dnk1000/Tandon-Tester-V2/docs/reference/kicad/PRELIMINARY_BOM.csv

Ref | Qty | Value/Part | Function | Status
U1 | 1 | ESP32-S3-WROOM-1-N8 | MCU | baseline
U2-U3 | 2 | SN74LS06 | open-collector floppy outputs | baseline
U4 | 1 | SN74LVC14A | 5V-tolerant Schmitt input buffer | baseline
U5 | 1 | LMR51430 | 12V to 5V 3A buck | baseline
U6-U7 | 2 | INA226 | current/voltage monitors | baseline
U8 | 1 | TLV75533 or equivalent | 3.3V regulator | select exact part
J1 | 1 | 2x17 shrouded 0.1in IDC | 34-pin floppy interface | select footprint
J2 | 1 | 4-pin TM100 power mating connector | drive power | select exact connector
J3 | 1 | USB-C USB2 device receptacle | console/programming | select exact connector
J4 | 1 | 12VDC input connector | power input | select exact connector
SW3 | 1 | DPDT locking toggle | physical Write Enable | select exact part
R30-R33 | 4 | 150R 0.5W | removable input termination | baseline
R40-R43 | 4 | 100R | input series damping/protection | baseline
R50-R51 | 2 | 0.025R 1% >=0.5W | current shunts | baseline
R60 | 1 | 100k 1% | buck top feedback | TI example
R61 | 1 | 13.7k 1% | buck bottom feedback | TI example
L1 | 1 | 6.8uH >=4A RMS >=5A sat | buck inductor | TI example
C11-C12 | 2 | 4.7uF 50V X7R | buck input ceramics | TI recommendation
C13-C14 | 2 | 22uF 25V X7R | buck output ceramics | TI example
C10 | 1 | 0.1uF | buck bootstrap | TI example
F1 | 1 | 3.15A | input fuse | verify
D1 | 1 | SMBJ15A or suitable | 12V input TVS | verify exact part
