dnk1000/Tandon-Tester-V2/docs/reference/kicad/TM100_Tester.sch

## KiCad design docs/reference/kicad/TM100_Tester.sch (2026-10-17)

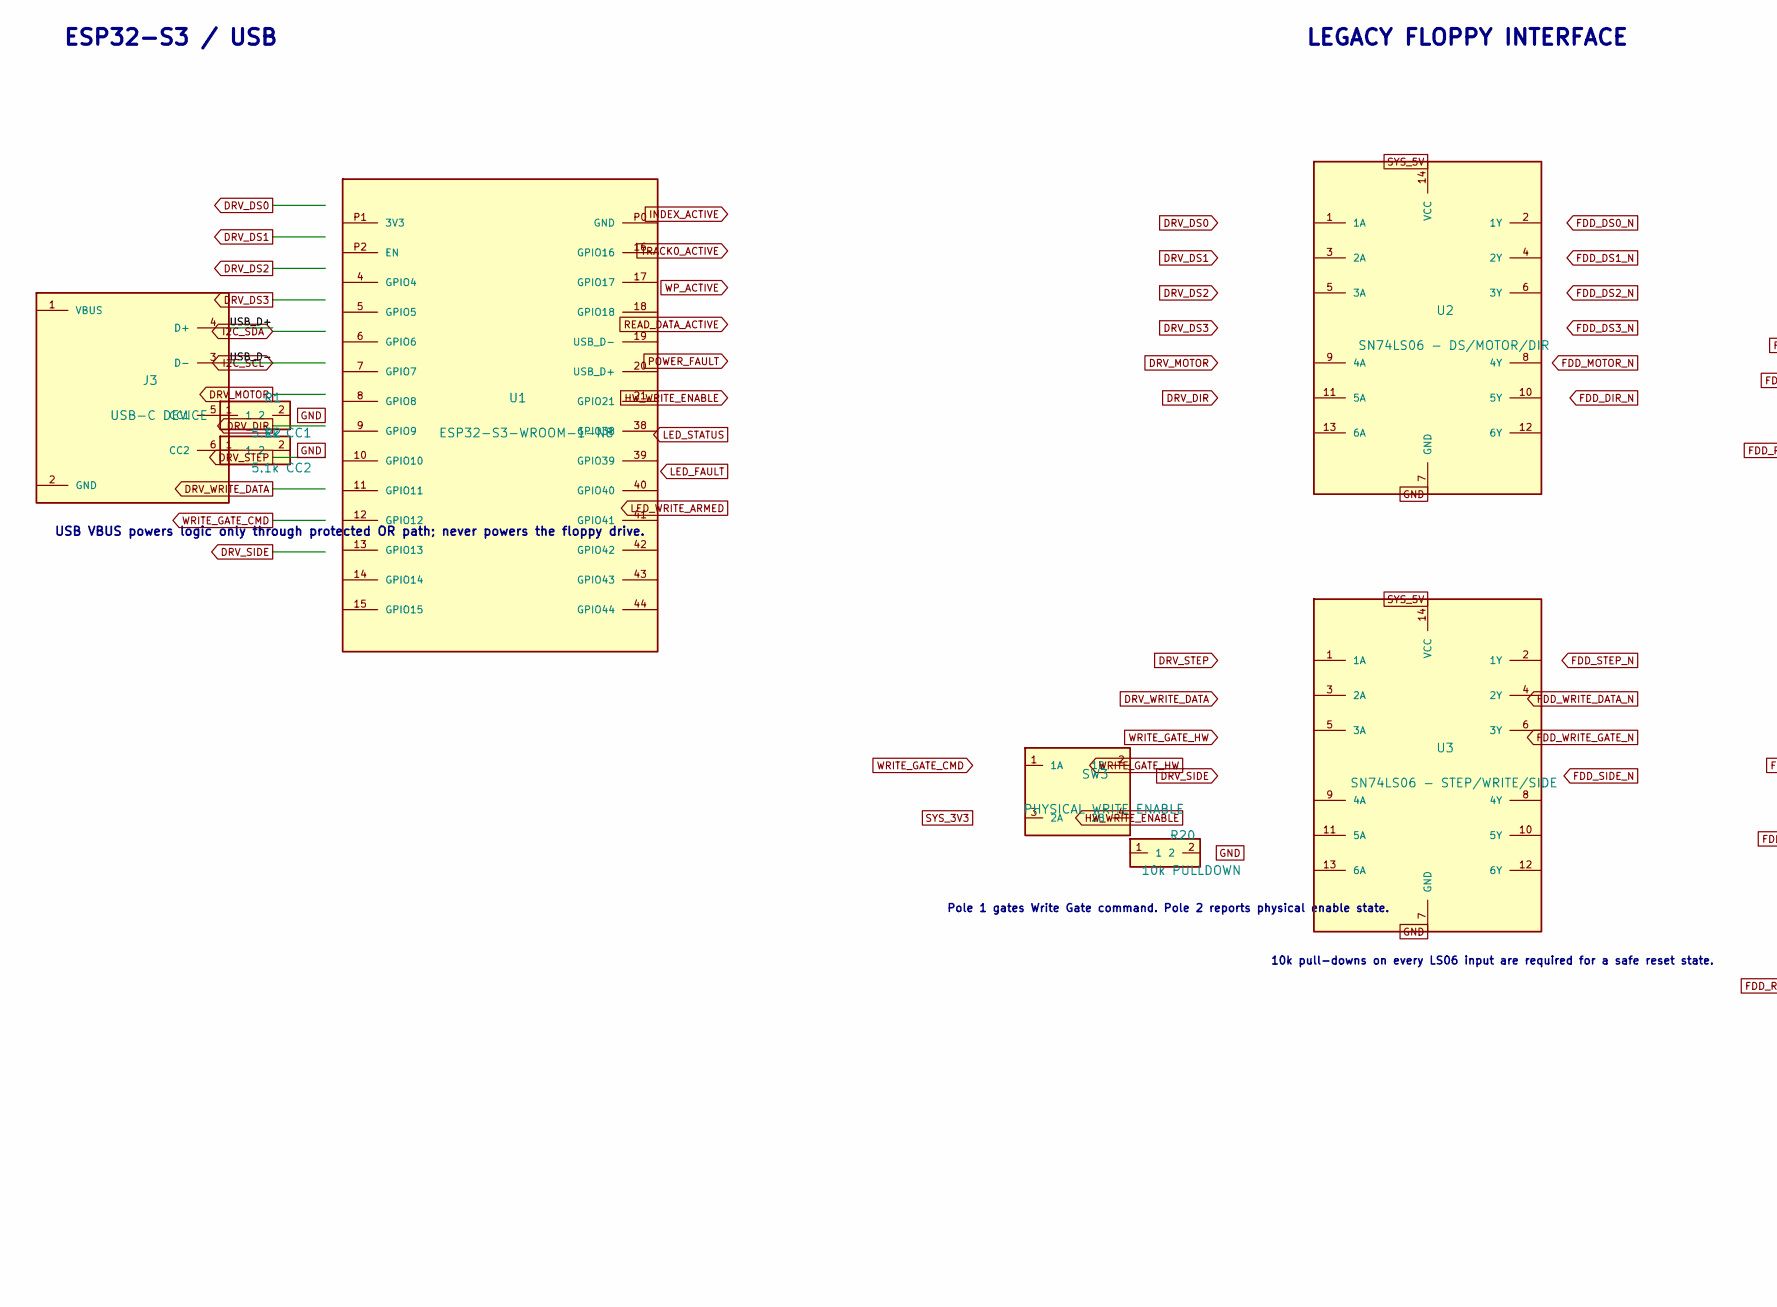
[picture p1: schematic TM100_Tester.sch, part in row 1, column 1]

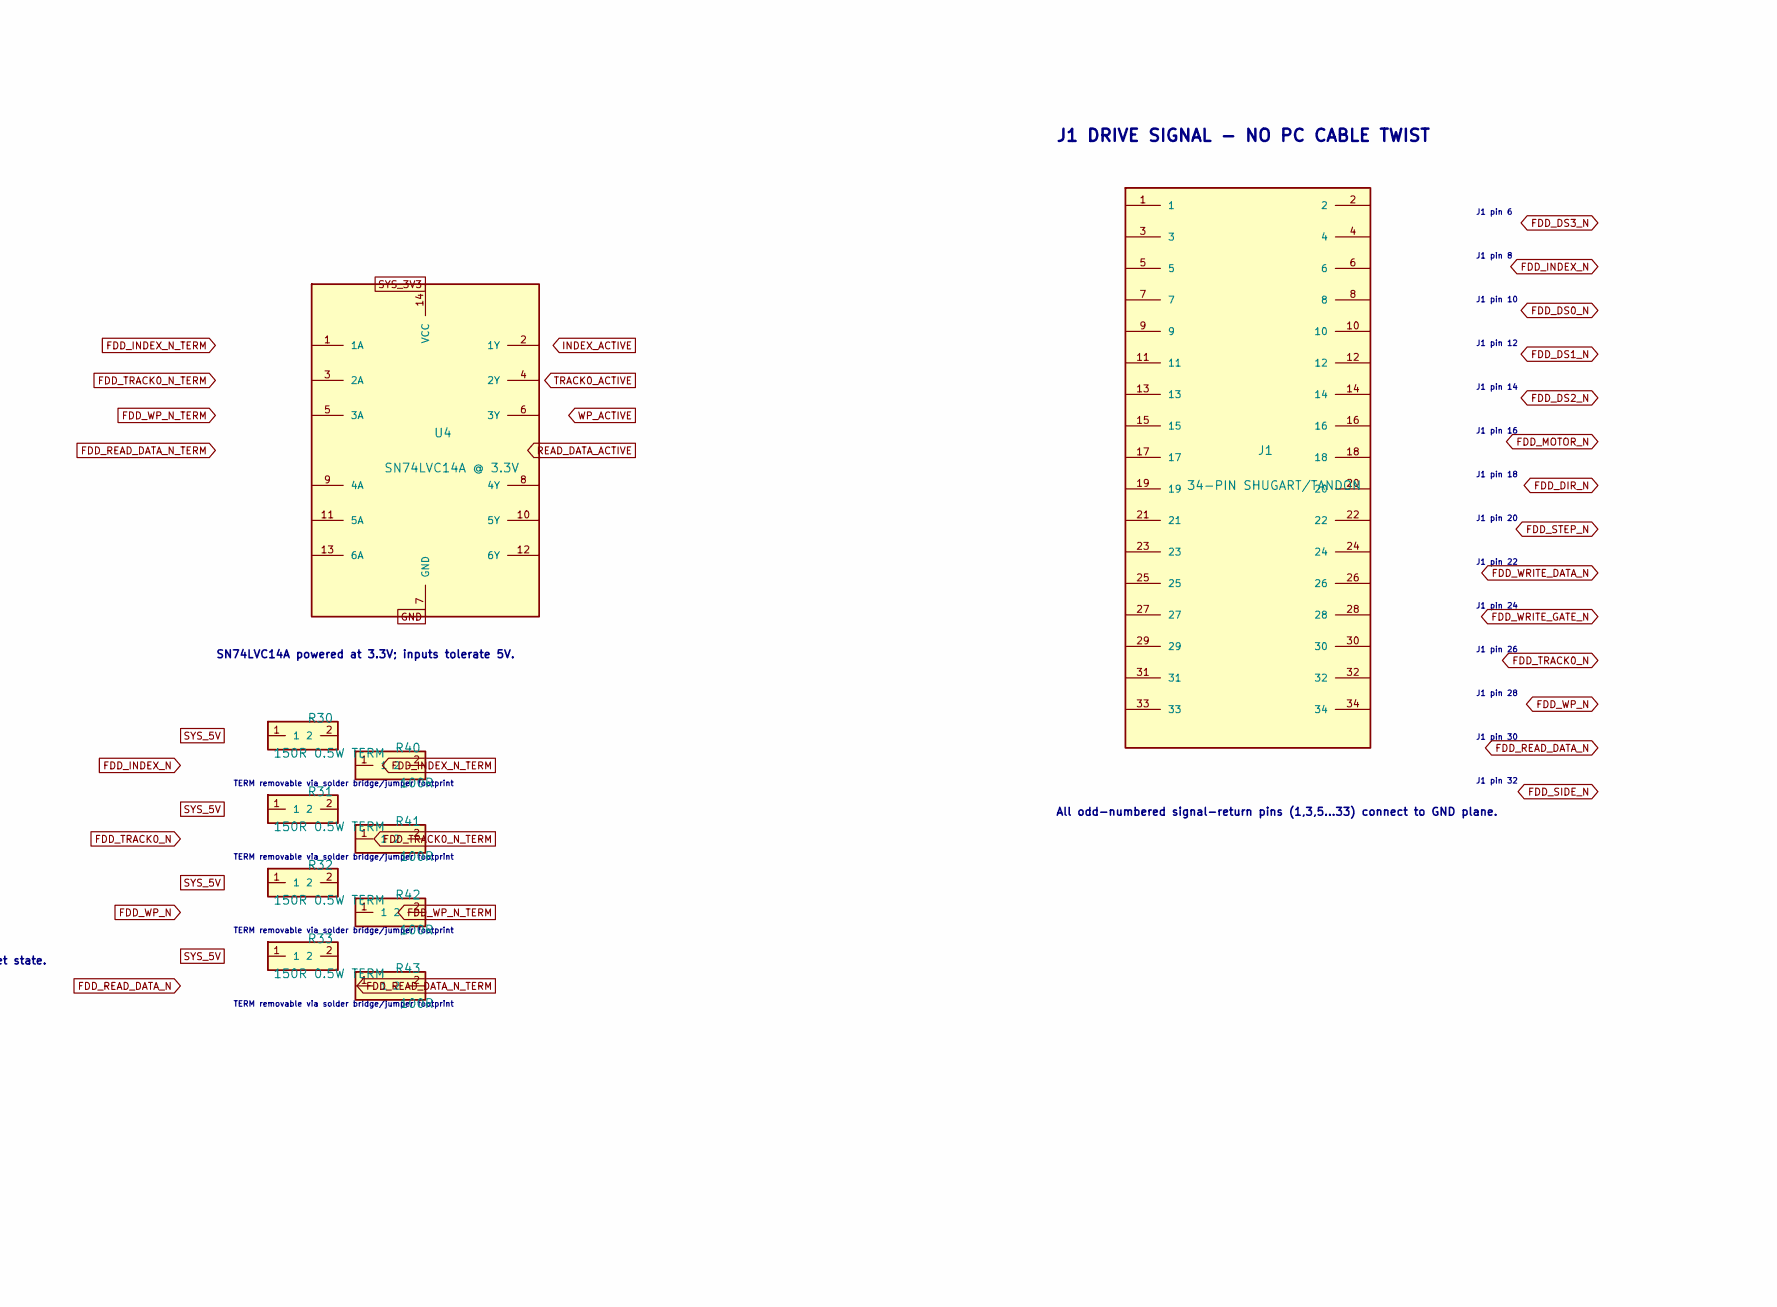
[picture p2: schematic TM100_Tester.sch, part in row 1, column 2]

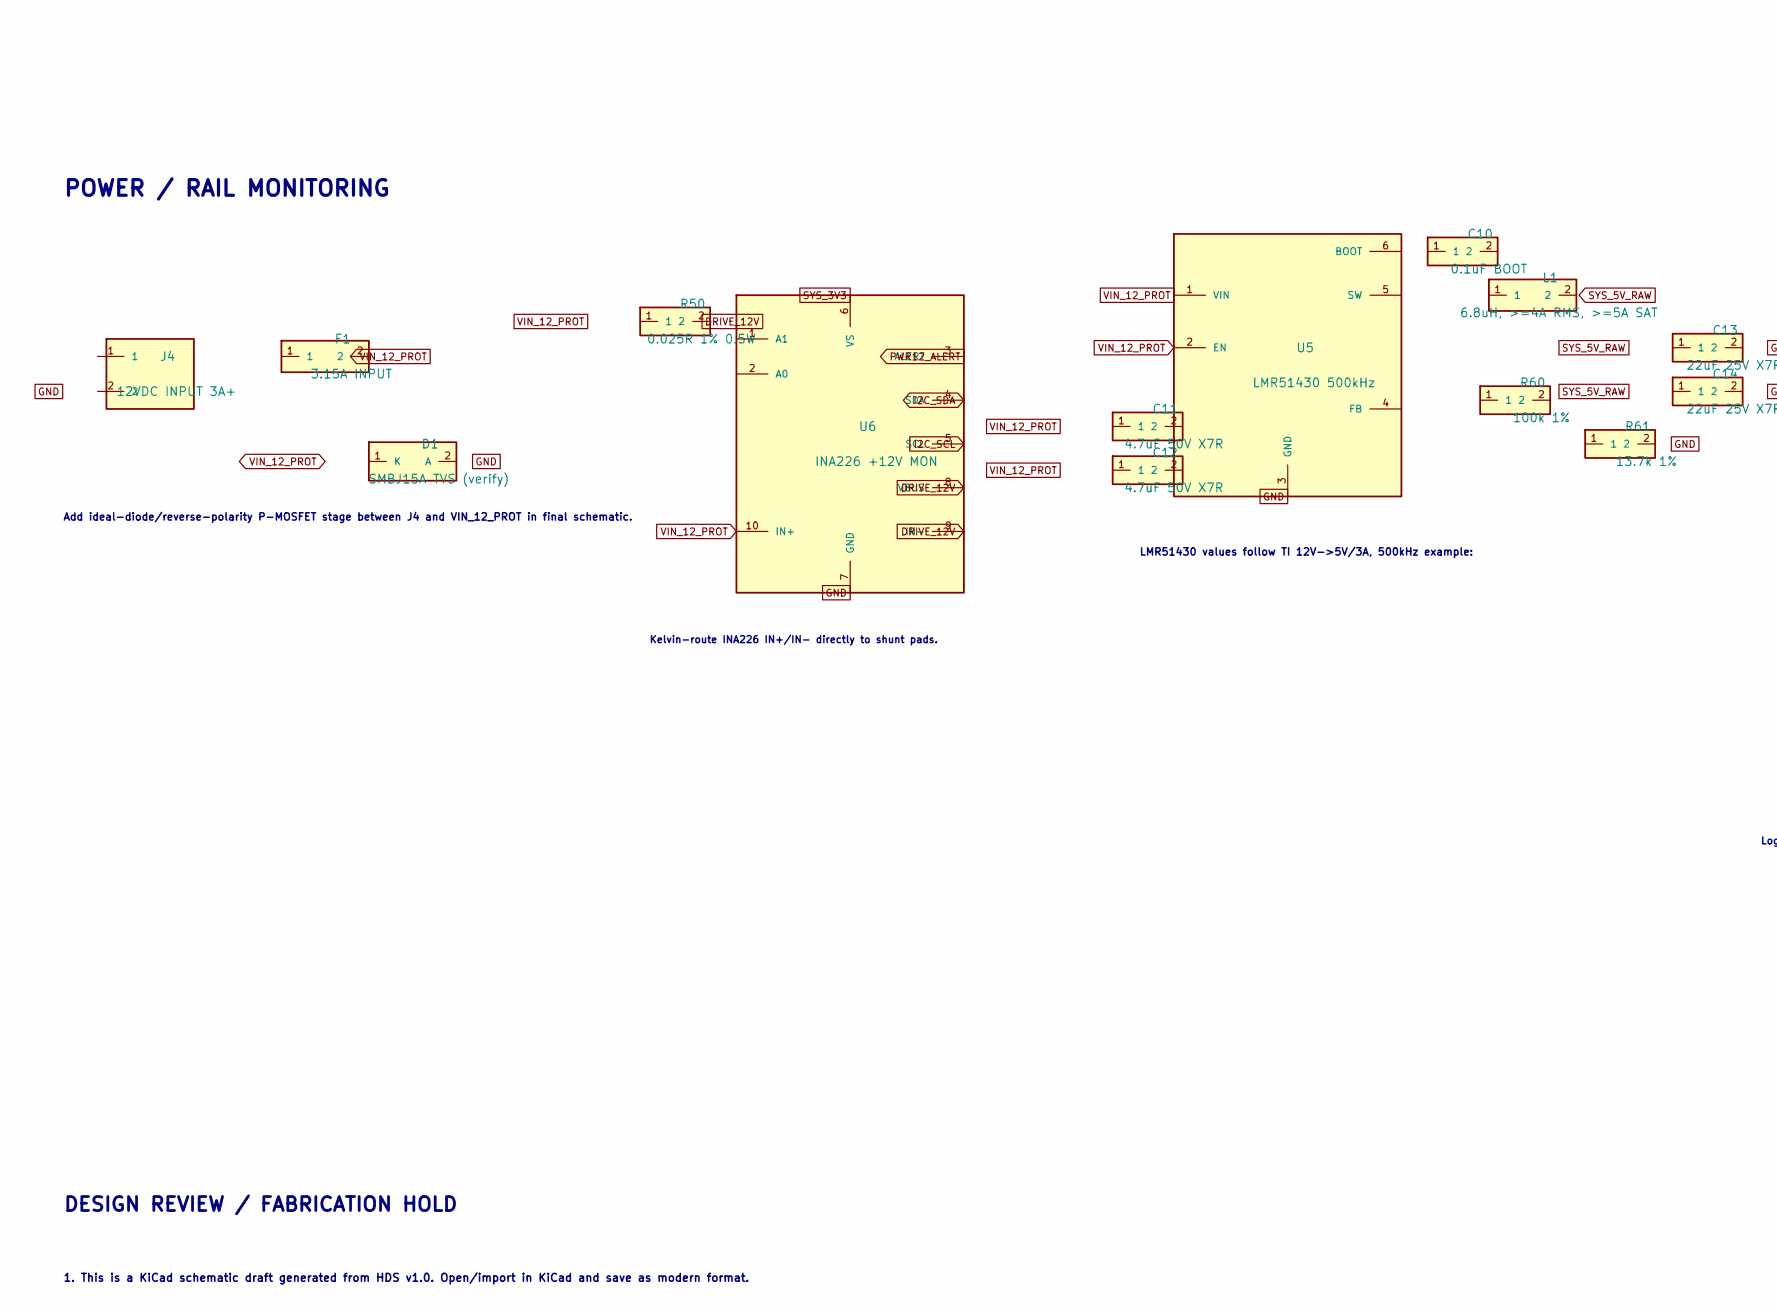
[picture p3: schematic TM100_Tester.sch, part in row 2, column 1]

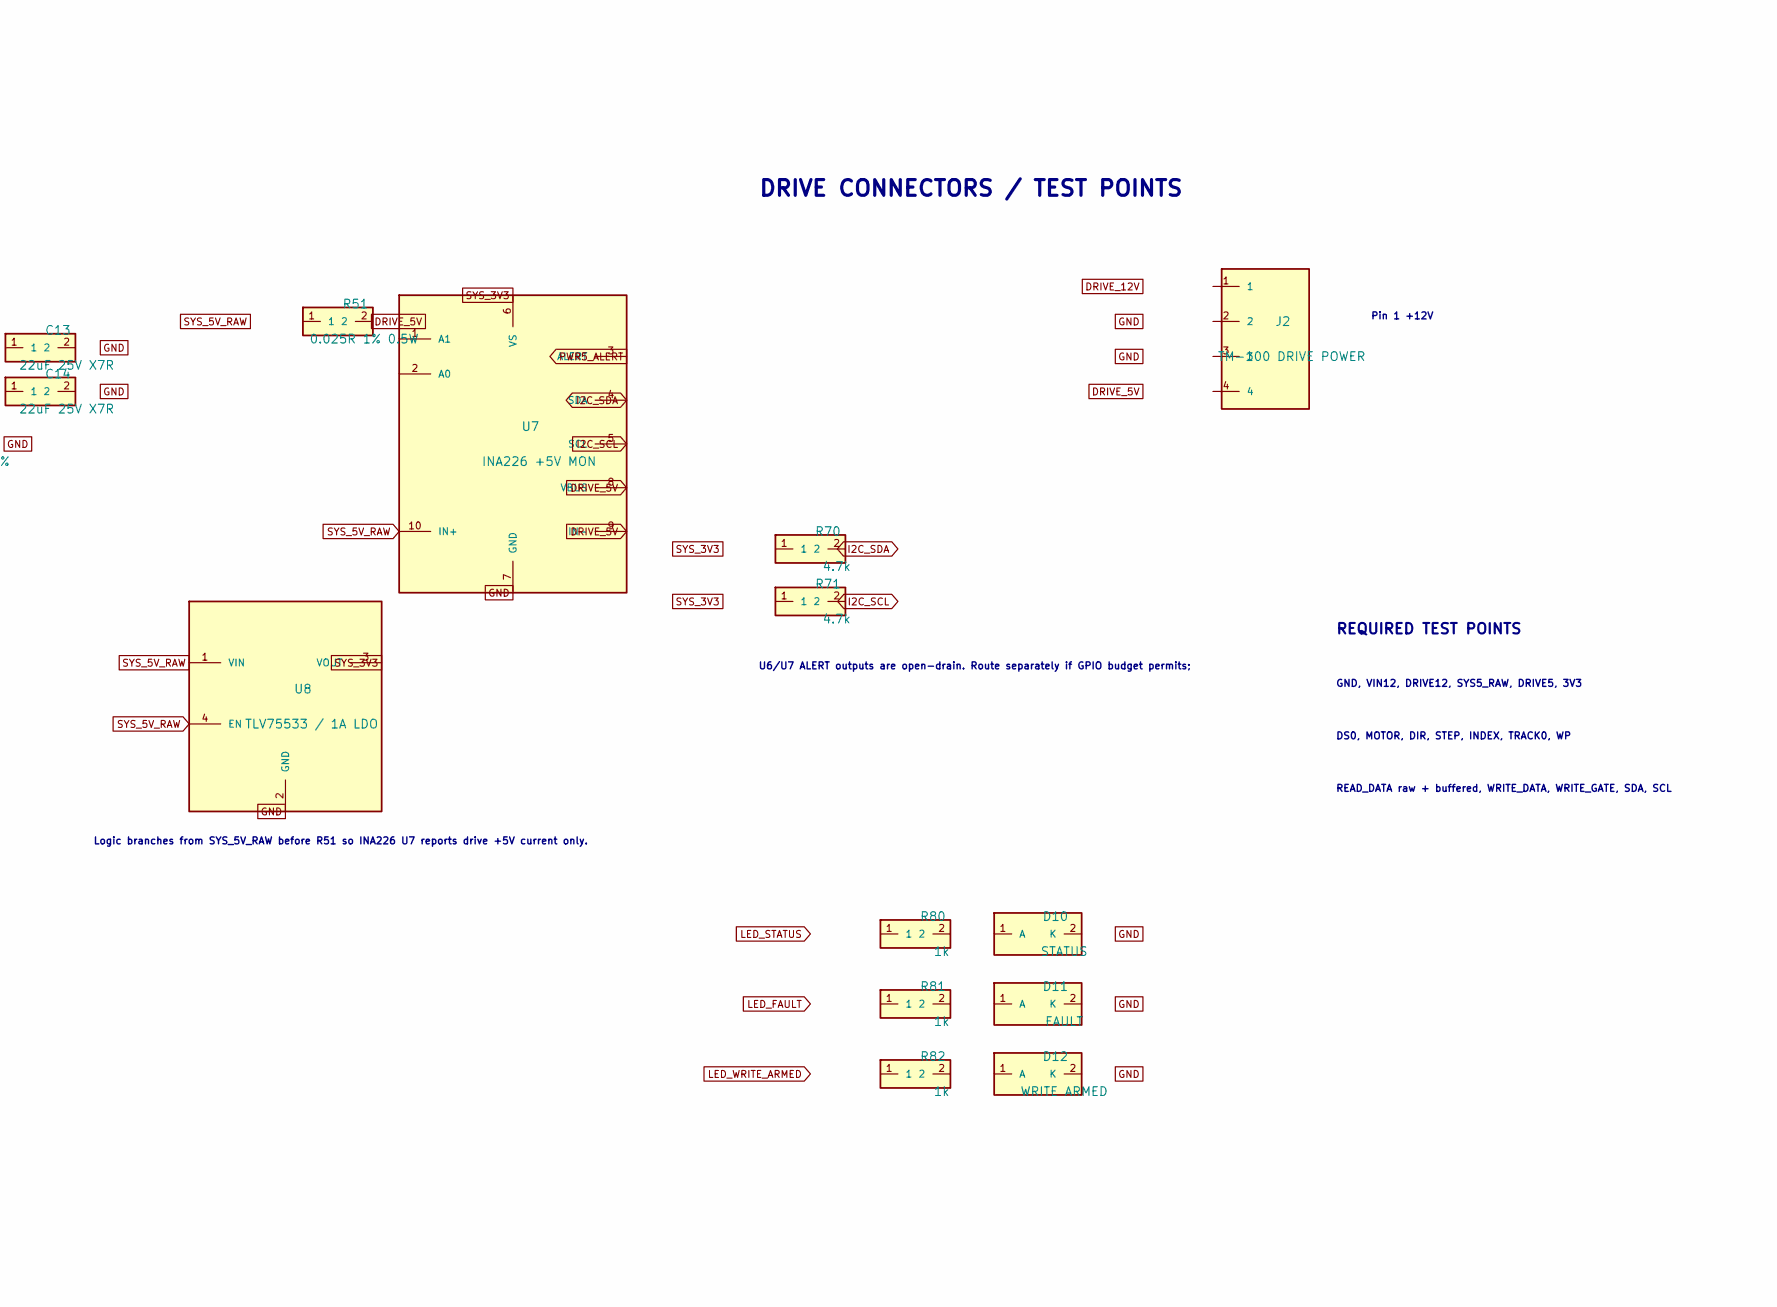
[picture p4: schematic TM100_Tester.sch, part in row 2, column 2]

Parts:
C10: 0.1uF BOOT
C11, C12: 4.7uF 50V X7R
C13, C14: 22uF 25V X7R
D1: SMBJ15A TVS (verify)
D10: STATUS
D11: FAULT
D12: WRITE ARMED
F1: 3.15A INPUT
J1: 34-PIN SHUGART/TANDON
J2: TM-100 DRIVE POWER
J3: USB-C DEVICE
J4: 12VDC INPUT 3A+
L1: 6.8uH, >=4A RMS, >=5A SAT
R1: 5.1k CC1
R2: 5.1k CC2
R20: 10k PULLDOWN
R30, R31, R32, R33: 150R 0.5W TERM
R40, R41, R42, R43: 100R
R50, R51: 0.025R 1% 0.5W
R60: 100k 1%
R61: 13.7k 1%
R70, R71: 4.7k
R80, R81, R82: 1k
SW3: PHYSICAL WRITE ENABLE
U1: ESP32-S3-WROOM-1-N8
U2: SN74LS06 - DS/MOTOR/DIR
U3: SN74LS06 - STEP/WRITE/SIDE
U4: SN74LVC14A @ 3.3V
U5: LMR51430 500kHz
U6: INA226 +12V MON
U7: INA226 +5V MON
U8: TLV75533 / 1A LDO

Connections:
DRIVE_5V: U7.8 (VBUS), U7.9 (IN-)
DRIVE_12V: U6.8 (VBUS), U6.9 (IN-)
GND: U2.7 (GND), U3.7 (GND), U4.7 (GND), U5.3 (GND), U6.7 (GND), U7.7 (GND), U8.2 (GND)
I2C_SCL: J3.3 (D-), U6.5 (SCL), U7.5 (SCL)
I2C_SDA: U6.4 (SDA), U7.4 (SDA)
PWR5_ALERT: U7.3 (ALERT)
PWR12_ALERT: U6.3 (ALERT)
SYS_3V3: U4.14 (VCC), U6.6 (VS), U7.6 (VS), U8.3 (VOUT)
SYS_5V: U2.14 (VCC), U3.14 (VCC)
SYS_5V_RAW: U7.10 (IN+), U8.1 (VIN), U8.4 (EN)
USB_D+: J3.4 (D+)
VIN_12_PROT: U5.1 (VIN), U5.2 (EN), U6.10 (IN+)

Notes on the sheet:
ESP32-S3 / USB
LEGACY FLOPPY INTERFACE
POWER / RAIL MONITORING
DRIVE CONNECTORS / TEST POINTS
USB VBUS powers logic only through protected OR path; never powers the floppy drive.
10k pull-downs on every LS06 input are required for a safe reset state.
Pole 1 gates Write Gate command. Pole 2 reports physical enable state.
SN74LVC14A powered at 3.3V; inputs tolerate 5V.
TERM removable via solder bridge/jumper footprint
J1 DRIVE SIGNAL - NO PC CABLE TWIST
J1 pin 6
J1 pin 8
J1 pin 10
J1 pin 12
J1 pin 14
J1 pin 16
J1 pin 18
J1 pin 20
J1 pin 22
J1 pin 24
J1 pin 26
J1 pin 28
J1 pin 30
J1 pin 32
All odd-numbered signal-return pins (1,3,5...33) connect to GND plane.
Pin 1 +12V
Add ideal-diode/reverse-polarity P-MOSFET stage between J4 and VIN_12_PROT in final schematic.
Kelvin-route INA226 IN+/IN- directly to shunt pads.
LMR51430 values follow TI 12V->5V/3A, 500kHz example:
Logic branches from SYS_5V_RAW before R51 so INA226 U7 reports drive +5V current only.
U6/U7 ALERT outputs are open-drain. Route separately if GPIO budget permits;
REQUIRED TEST POINTS
GND, VIN12, DRIVE12, SYS5_RAW, DRIVE5, 3V3
DS0, MOTOR, DIR, STEP, INDEX, TRACK0, WP
READ_DATA raw + buffered, WRITE_DATA, WRITE_GATE, SDA, SCL
DESIGN REVIEW / FABRICATION HOLD
1. This is a KiCad schematic draft generated from HDS v1.0. Open/import in KiCad and save as modern format.
