dnk1000/Tandon-Tester-V2/main/timing.c

/**
 * @file timing.c
 * @brief Streaming reduction of 50 ns RMT durations into pulse-interval statistics.
 */
#include "measurements.h"
#include <string.h>
#include <limits.h>
/**
 * @brief Reset the interval reducer before a new contiguous capture.
 *
 * @param a Non-NULL streaming accumulator retaining state across contiguous segments.
 */
void timing_accumulator_init(timing_accumulator_t *a)
{
    memset(a,0,sizeof(*a)); a->previous_level=-1; a->result.min_ticks=UINT32_MAX;
}
/**
 * @brief Consume one duration while preserving rising-edge state across DMA blocks.
 *
 * @param a Non-NULL streaming accumulator retaining state across contiguous segments.
 * @param level Buffered signal level, 0 or 1.
 * @param ticks Duration in 50 ns ticks; zero denotes an ignored end marker.
 * @param limit Maximum complete intervals to retain.
 */
void timing_accumulator_feed(timing_accumulator_t *a, unsigned level, uint32_t ticks, unsigned limit)
{
    if (!ticks || a->result.samples>=limit) return;
    // Ignore the initial fragment; only transitions from a known LOW start pulses.
    if (level && a->previous_level==0) {
        if (a->have_rise) {
            uint32_t interval=(uint32_t)(a->elapsed-a->last_rise);
            timing_reading_t *r=&a->result;
            if (interval<r->min_ticks) r->min_ticks=interval;
            if (interval>r->max_ticks) r->max_ticks=interval;
            r->sum_ticks+=interval;
            ++r->samples;
            unsigned bin=interval/20; // 20MHz: 1us bins [n,n+1), last >=15us
            ++r->histogram[bin<15?bin:15];
        }
        a->last_rise=a->elapsed;
        a->have_rise=true;
    }
// Carry elapsed time and level into the next half-symbol or DMA callback.
    a->previous_level=(int)level;
    a->elapsed+=ticks;
}
